baongoc10112002/Automated-Sorting-System/Poster.pdf

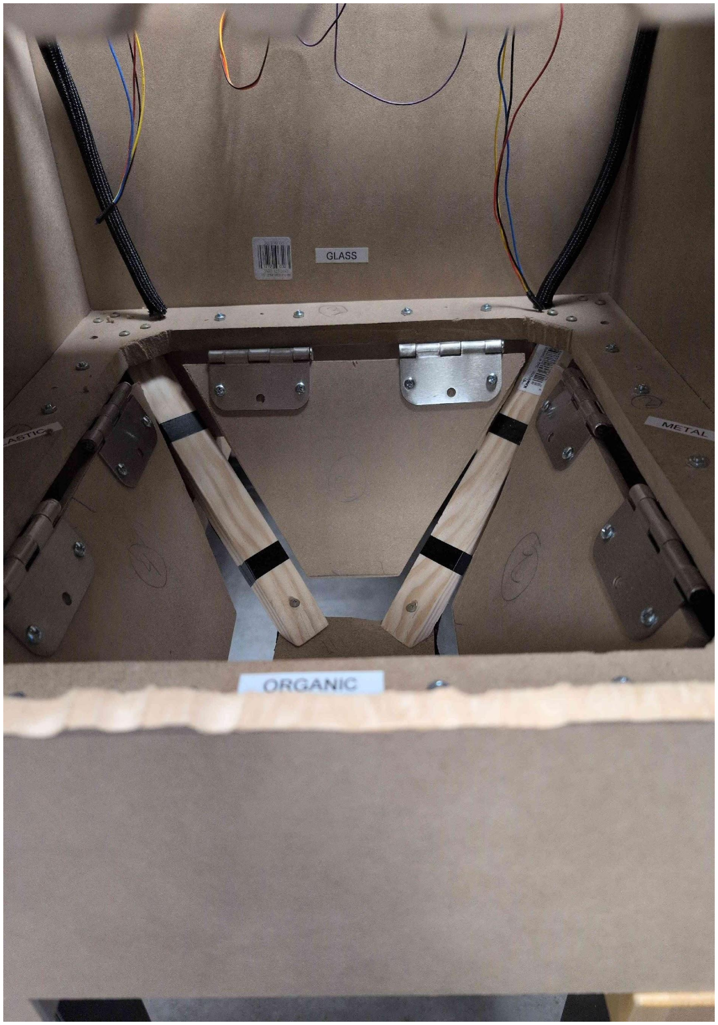
[picture p34: figure]

## Results

- System Architecture: The system utilizes a camera connected to an Arduino board, which serves as the central processing unit. The Arduino interfaces with the necessary electronic components.

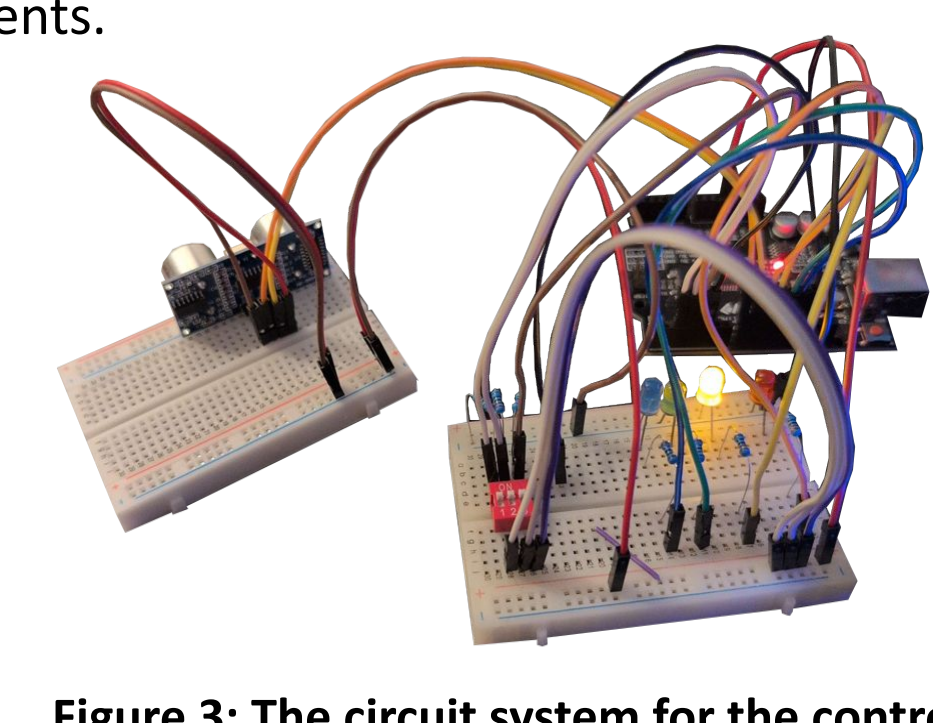
[picture p35: figure]

•Bin Level Monitoring: The system uses sonic sensors to monitor the fill level of each bin, indicating when they need to be emptied. •Automated Doors: Doors operate automatically when an object is detected, with each door corresponding to a specific waste category (plastic, metal, glass, or garbage).
•Sorting Process: After the bin is assembled and the camera is trained to recognize objects, the system sorts the objects into the appropriate bins.

## Authors: Joel Dumevi, Rafael Mercado, Tran Bao Ngoc Nguyen, Rodion Pelykh, Tylor Reed

### Department of Electrical Engineering and Computer Science

# Senior Design Project: Automatic Sorting System

## Conclusion

•Project Aim: Provide a convenient, efficient, and user-friendly solution for recycling waste.
•Future Development:
•Improve object recognition to handle a wider variety of items.
•Potentially integrate a barcode reading system for increased accuracy.

References:

1. Gravity: HUSKYLENS AI Machine Vision Sensor - DFRobot Wiki (https://wiki.dfrobot.com/HUSKYLENS_V1.0_SKU_SEN0305_SEN0336)
2. Adding AI Vision To A Robot Car Using A Huskylens - The DIY Life (https://www.the-diy-life.com/adding-ai-vision-to-a-robot-car-using-a-huskylens/)
3. GitHub - HuskyLens/HUSKYLENSArduino (https://github.com/HuskyLens/HUSKYLENSArduino)
4. LIZARD: Pervasive Sensing for Autonomous Plastic Litter Monitoring | IEEE
Conference Publication | IEEE Xplore (https://ieeexplore.ieee.org/document/10562171)
5. WasteMiner: An Efficient Waste Collection System for Smart Cities Leveraging IoT and Data Mining Technique - Experts@Syracuse (https://experts.syr.edu/en/publications/wasteminer-an-efficient-waste-collection-system-for-smart-cities-)

## Introduction

- Goal: Develop a multi-purpose recycling bin capable of automatically sorting waste into four categories:
- Plastic
- Metal
- Glass
- Organics (for items that don't fit the other categories or are mistakenly placed in the bin)
- Purpose: Simplify and automate the recycling process to:
- Increase convenience
- Improve the accuracy of waste sorting

## Methods

This project is centered around the capabilities of an AI-assisted camera, designed to recognize various objects and classify them into predefined categories.
The system utilizes the Huskylens AI camera for object detection and classification.

Results Cont.
After an extended period of training the camera, it can now distinguish between 4 categories of objects:
- Metal
- Plastic
- Glass
- Trash
And as a result, the final components are being put into a more permanent, wooden
frame.

Acknowledgement:
1. Project Advisor: Dr. Samia Tasnim
2. Senior Design Professor: Dr. Liang Cheng
3. Project Sponsor: The University of Toledo

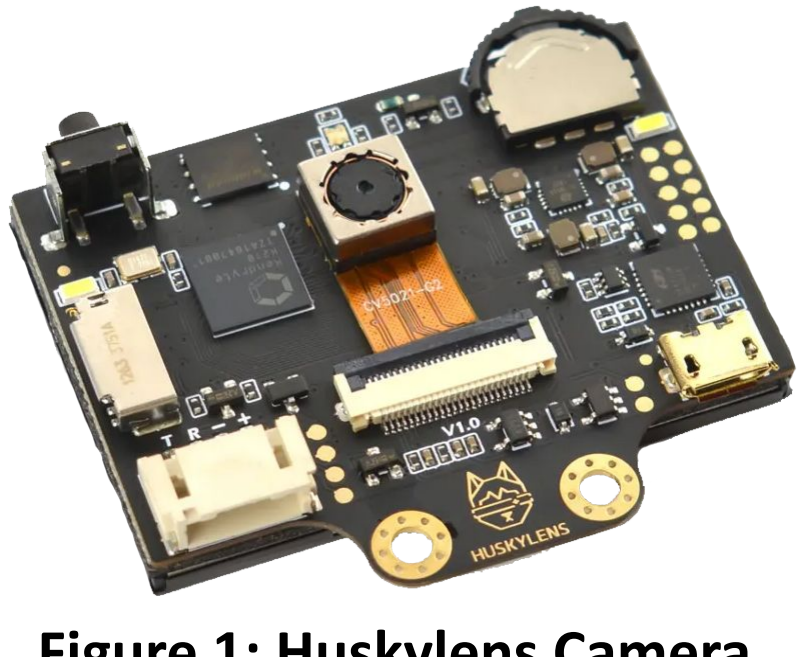
[picture p36: figure]

Figure 1: Huskylens Camera

Figure 3: The circuit system for the controller

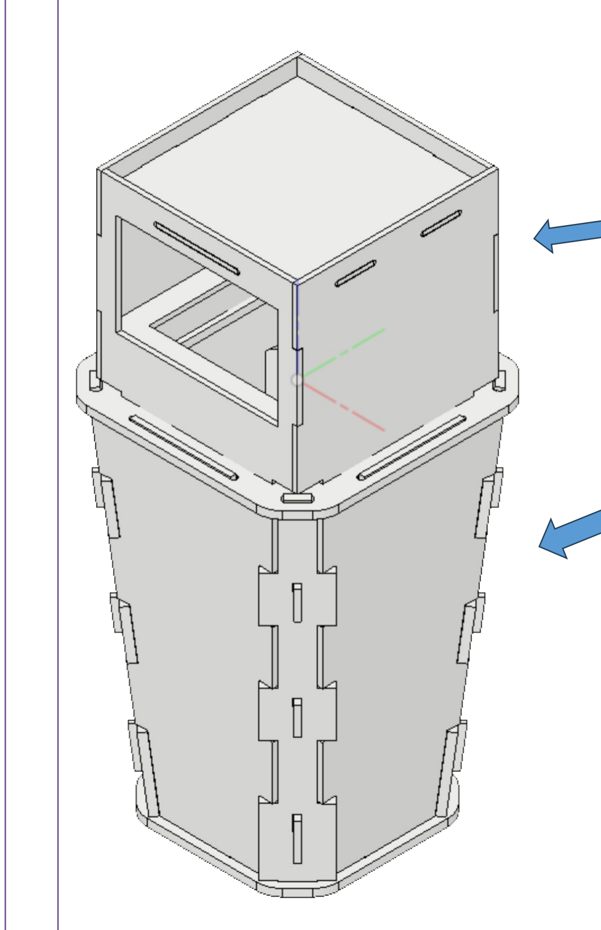
[picture p37: figure]

Figure 4: Render for
the bin, containing the
system

Top bin: houses all of
the electronics

Bottom bin: contains all
the sorted garbage and
recyclables

The electronics were initially put onto the cardboard
frame, imitating the final product for testing purposes.

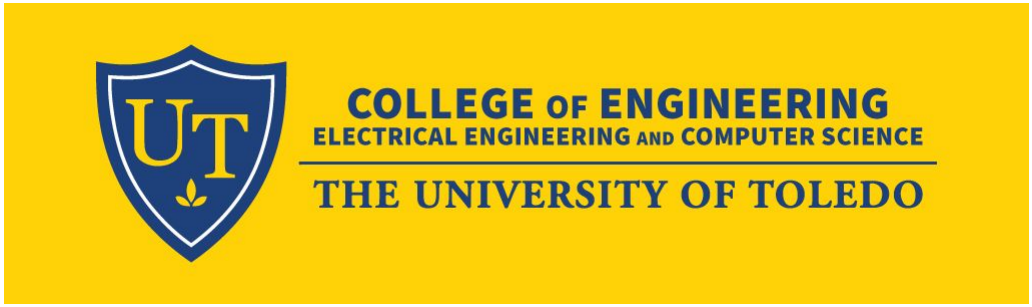
[picture p38: figure]

Figure 5: Cost table

Figure 6: The sorting gates

Arduino board: | $43.56
Electronics (Wires and motors): | $106.8
Raw materials (Wood and hardware): | $100
Peripherals: | $41.31
Total: | $291.67

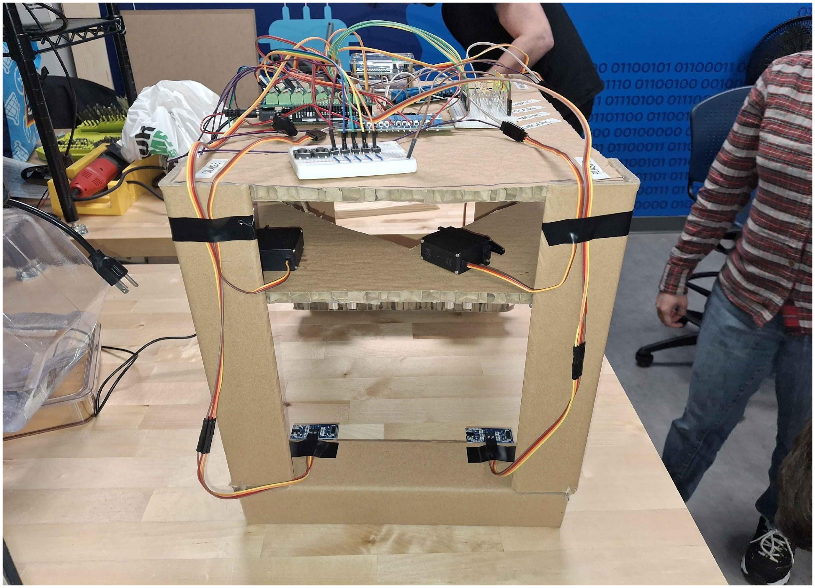
[picture p39: figure]

Figure 2: Electronics on a temporary setup

The project methodology is divided into the following steps:

### 1. Research & Design 2. Hardware Assembly 3. Programming 4. Testing & Optimization
